milestorm/SlotMachine/assets/graphics/button_design.pdf

# BET & SPIN button labels

Print them on sticker paper, and put into the buttons
