milestorm/SlotMachine/assets/slot_machine_arduino_pinout.png

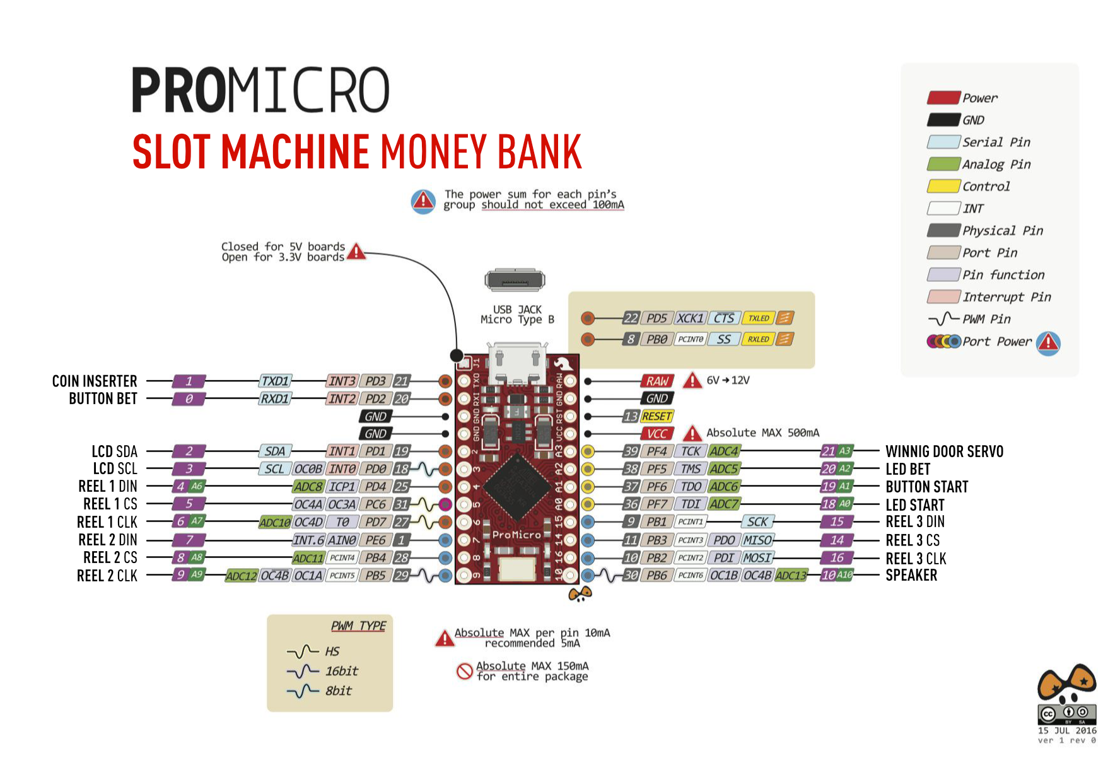
assets/slot_machine_arduino_pinout.png
