milestorm/SlotMachine/assets/stl/smmb_inner-top.stl

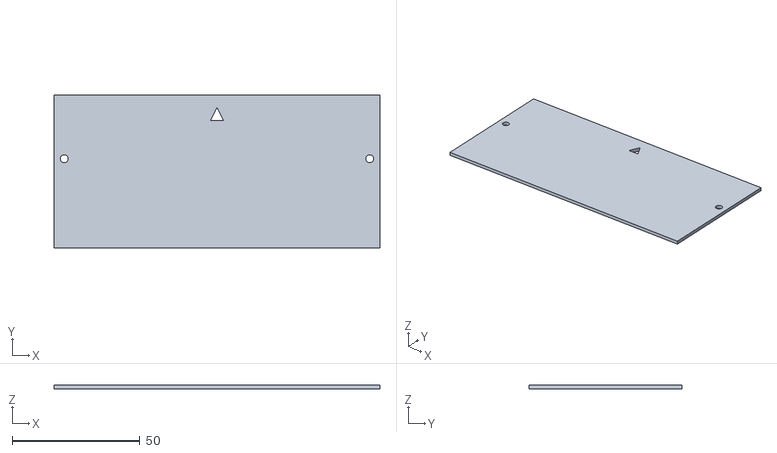
[picture p3: CAD file, 2019-04-17]
assets/stl/smmb_inner-top.stl
127.5 x 60.0 x 1.50
