milestorm/SlotMachine/assets/stl/smmb_inner-middle.stl

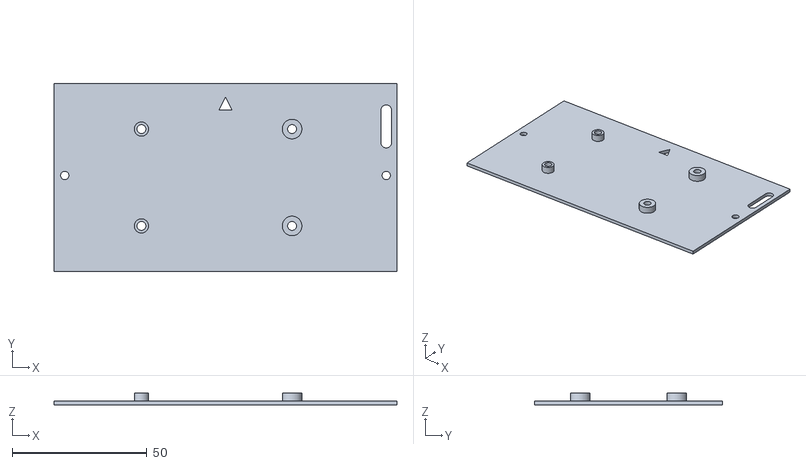
[picture p4: CAD file, 2019-04-17]
assets/stl/smmb_inner-middle.stl
127.5 x 70.0 x 4.50
