milestorm/SlotMachine/assets/stl/smmb_inner-bottom.stl

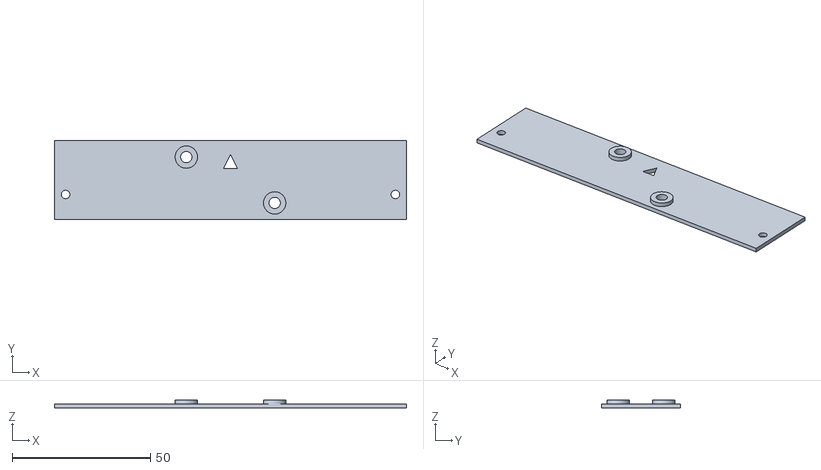
[picture p5: CAD file, 2019-04-17]
assets/stl/smmb_inner-bottom.stl
127.5 x 28.5 x 3.00
