milestorm/SlotMachine/assets/stl/smmb_coin-thrower.stl

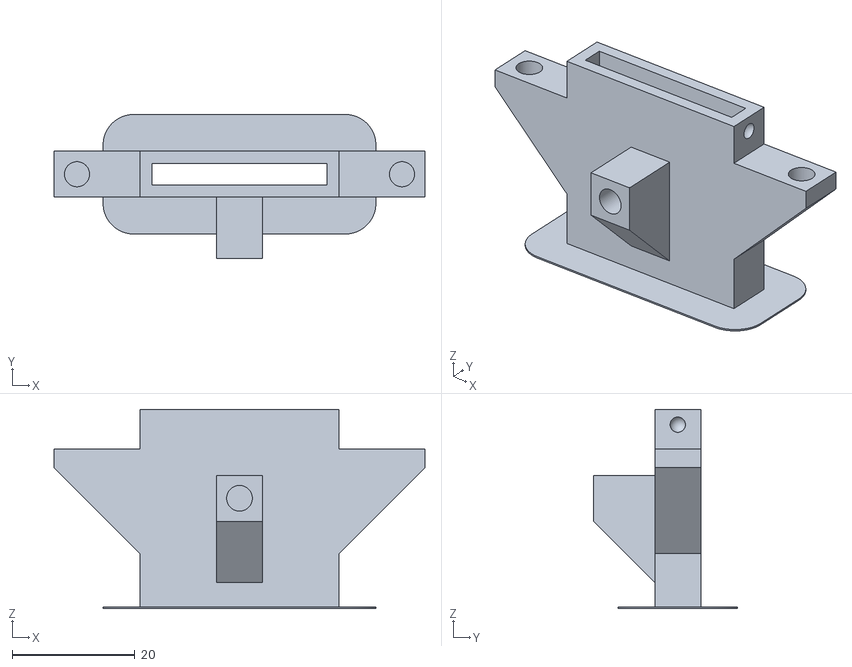
[picture p6: CAD file, 2019-04-17]
assets/stl/smmb_coin-thrower.stl
60.5 x 23.5 x 32.5
