milestorm/SlotMachine/assets/stl/smmb_front-lcd-buttons.stl

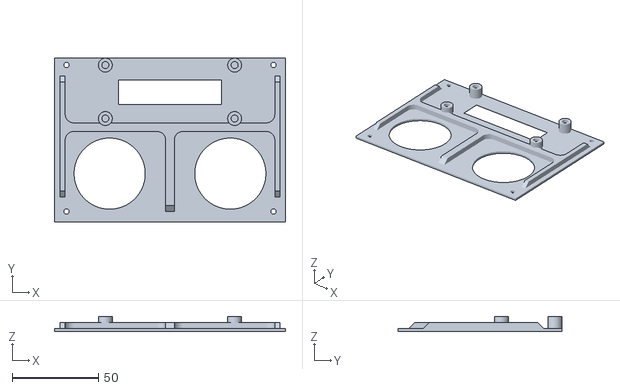
[picture p7: CAD file, 2019-04-17]
assets/stl/smmb_front-lcd-buttons.stl
134.0 x 95.0 x 8.50
