milestorm/SlotMachine/assets/stl/smmb_side-right.stl

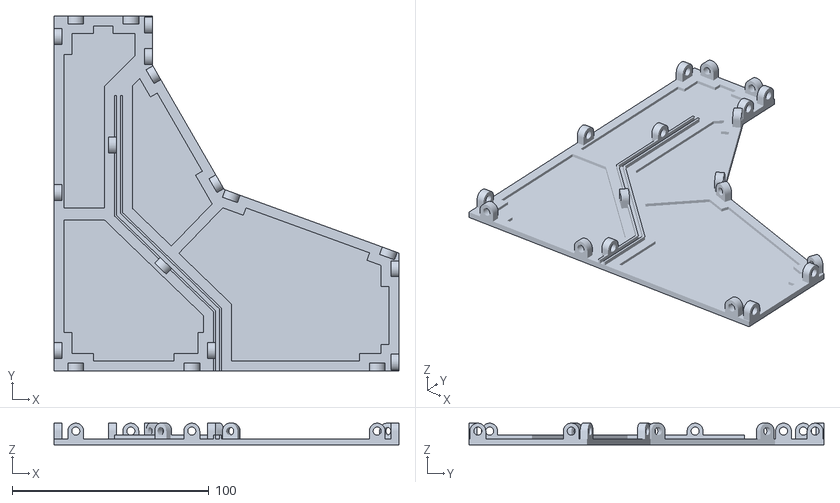
[picture p8: CAD file, 2019-04-17]
assets/stl/smmb_side-right.stl
175.3 x 180.5 x 11.1
