milestorm/SlotMachine/assets/stl/smmb_led-matrix-holder.stl

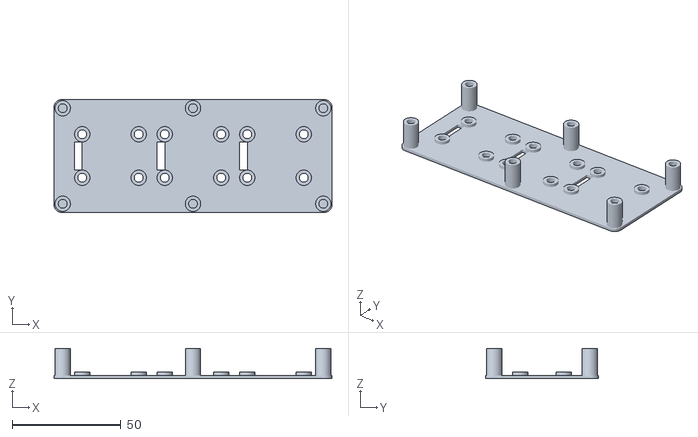
[picture p9: CAD file, 2019-04-17]
assets/stl/smmb_led-matrix-holder.stl
128.0 x 52.0 x 14.0
