milestorm/SlotMachine/assets/stl/smmb_front-bottom.stl

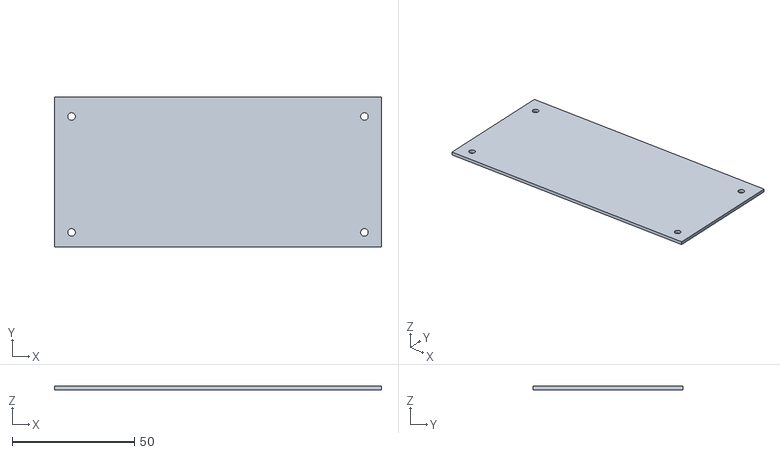
[picture p10: CAD file, 2019-04-17]
assets/stl/smmb_front-bottom.stl
134.0 x 61.5 x 1.50
