milestorm/SlotMachine/assets/stl/smmb_front-top.stl

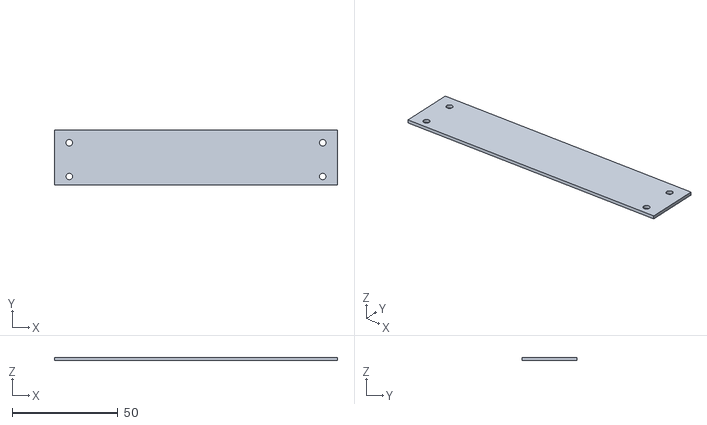
[picture p11: CAD file, 2019-04-17]
assets/stl/smmb_front-top.stl
134.0 x 26.0 x 1.50
