milestorm/SlotMachine/assets/stl/smmb_front-led-matrix.stl

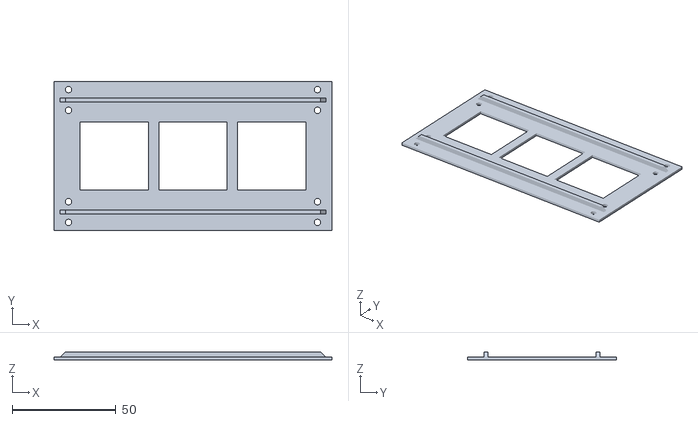
[picture p12: CAD file, 2019-04-17]
assets/stl/smmb_front-led-matrix.stl
134.0 x 72.0 x 4.00
