milestorm/SlotMachine/assets/stl/smmb_top.stl

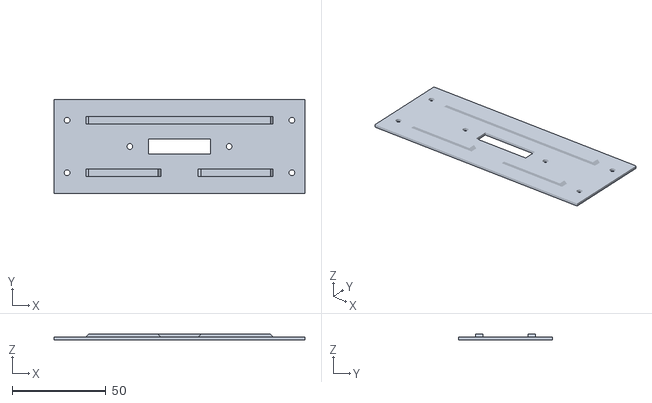
[picture p13: CAD file, 2019-04-17]
assets/stl/smmb_top.stl
134.0 x 50.0 x 3.00
