milestorm/SlotMachine/assets/stl/smmb_coin-thrower-top.stl

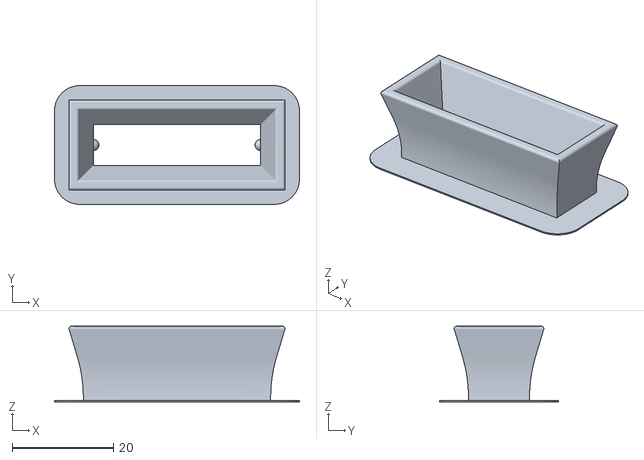
[picture p14: CAD file, 2019-04-17]
assets/stl/smmb_coin-thrower-top.stl
48.5 x 23.5 x 15.0
