milestorm/SlotMachine/assets/stl/smmb_back.stl

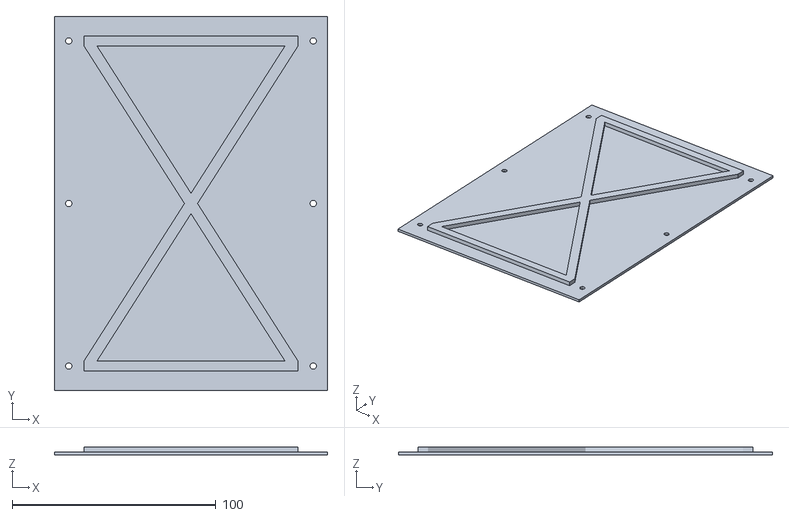
[picture p15: CAD file, 2019-04-17]
assets/stl/smmb_back.stl
134.0 x 183.5 x 4.00
