milestorm/SlotMachine/assets/stl/smmb_bottom.stl

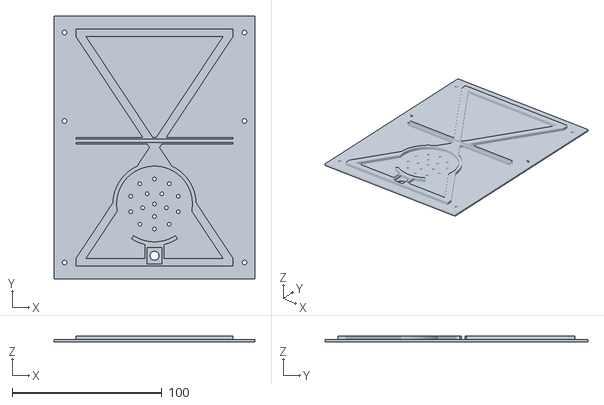
[picture p16: CAD file, 2019-04-17]
assets/stl/smmb_bottom.stl
134.0 x 175.3 x 4.00
