milestorm/SlotMachine/(list of files, cad)

Other CAD files:
assets/stl/smmb_side-left.stl
assets/fusion_360/smmb_back.f3d
assets/fusion_360/smmb_bottom.f3d
assets/fusion_360/smmb_coin-thrower-top.f3d
assets/fusion_360/smmb_coin-thrower.f3d
assets/fusion_360/smmb_front-bottom.f3d
assets/fusion_360/smmb_front-lcd-buttons.f3d
assets/fusion_360/smmb_front-led-matrix.f3d
assets/fusion_360/smmb_front-top.f3d
assets/fusion_360/smmb_inner-bottom.f3d
assets/fusion_360/smmb_inner-middle.f3d
assets/fusion_360/smmb_inner-top.f3d
assets/fusion_360/smmb_led-matrix-holder.f3d
assets/fusion_360/smmb_side-left.f3d
assets/fusion_360/smmb_side-right.f3d
assets/fusion_360/smmb_top.f3d
