milestorm/SlotMachine/assets/graphics/smmb_wiring.png

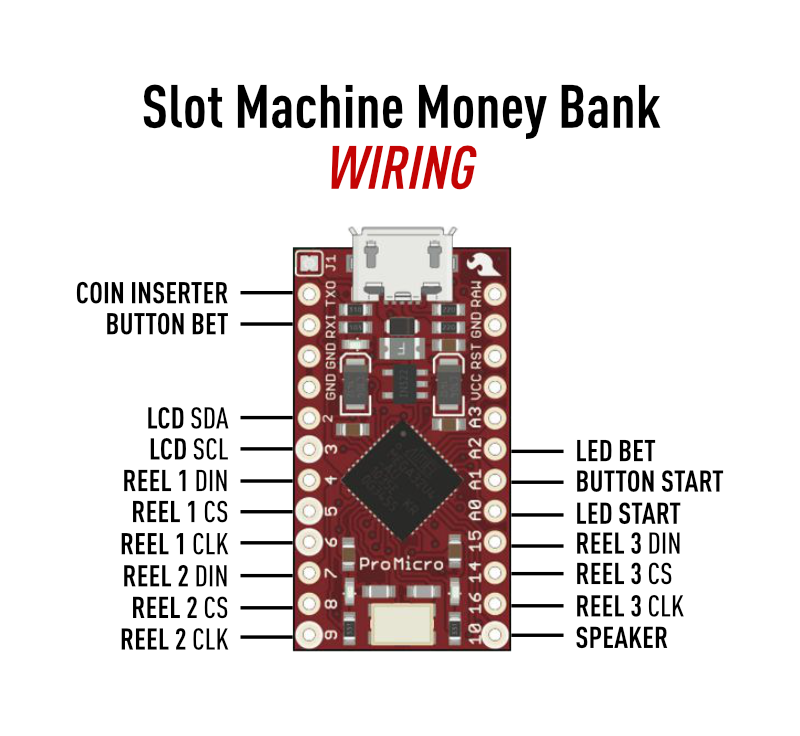
assets/graphics/smmb_wiring.png
