milestorm/SlotMachine/(commit log)

2019-03-20 slow start of cylinder
2019-03-25 it finally somehow works. I am on a right track
2019-03-30 added button
2019-03-31 bet button
2019-03-31 pin definitions
2019-03-31 coin inserter
2019-04-08 bet and start button decal design
2019-04-11 added models of the box
    [smmb_back.f3d, smmb_back.stl, smmb_bottom.f3d, smmb_bottom.stl, smmb_coin-thrower-top.f3d, smmb_coin-thrower-top.stl, smmb_coin-thrower.f3d, smmb_coin-thrower.stl]
2019-04-13 model update
    [smmb_bottom.f3d, smmb_bottom.stl]
2019-04-17 bet led added, updated bet scrolling
2019-04-18 button gfx update
